melihhin0tr/Sensor_CARD_V2/SensorV2/BOM/BOM_BME_2801_2026-05-30.csv

ID | Name | Designator | Footprint | Quantity | Manufacturer Part | Manufacturer | Supplier | Supplier Part | Price | Pins | 3DModel | Contributor | JLCPCB Part Class | Package Display | link | subpart_no | tags
1 | 4000Hz | BUZZER | BUZ-SMD_L4.0-W4.0-P3.50-L | 1 | FUET-4020 | FUET(福声科技) | LCSC | C391027 | 0.806 | 2 | BUZ-SMD_2P-L4.0-W4.0-H2.0 | LCSC | Extended Part | Yes | https://item.szlcsc.com/367489.html
2 | 4.7kΩ | R18 | R0603 | 1 | RC0603FR-074K7L | YAGEO(国巨) | LCSC | C99782 | 0.002 | 2 | R0603 | lcsc | Extended Part | Yes | https://www.mouser.in/datasheet/2/447/PYu_RT_1_to_0_01_RoHS_L_11-1669912.pdf
3 | 1kΩ | R19 | R0603 | 1 | RC0603FR-071KL | YAGEO(国巨) | LCSC | C22548 | 0.002 | 2 | R0603 | lcsc | Extended Part | Yes | https://www.mouser.in/datasheet/2/447/PYu_RT_1_to_0_01_RoHS_L_11-1669912.pdf
4 | BC847_C2913847 | U4 | SOT-23-3_L2.9-W1.3-P1.90-LS2.3-BR-1 | 1 | BC847 | null | LCSC | C2913847 |  | 3 | SOT-23-3_L2.9-W1.3-P1.90-LS2.3-BR-1 | LCSC | Extended Part | No | https://atta.szlcsc.com/upload/public/pdf/source/20190910/C426794_71CDF14A270A64EC9B81A2413D2B22AD.pdf
5 | 10K | R20 | R0603 | 1 |  |  |  |  |  | 2 | R0603 | LCEDA_Lib |  | No | https://www.mouser.in/datasheet/2/447/PYu_RT_1_to_0_01_RoHS_L_11-1669912.pdf
6 | 10uF | C14 | C0603 | 1 | CL10A106KP8NNNC | SAMSUNG(三星) | LCSC | C19702 | 0.013 | 2 | C0603_L1.6-W0.8-H0.8 | lcsc | Basic Part | Yes | https://item.szlcsc.com/362304.html
7 | 353120460 | I2C1,UART4 | CONN-TH_353120460 | 2 | 353120460 | MOLEX | LCSC | C185200 | 0.287 | 4 | CONN-TH_353120460 | LCSC | Extended Part | Yes | https://item.szlcsc.com/196605.html
8 | 22Ω | R15,R16 | R0603 | 2 | RC0603FR-0722RL | YAGEO(国巨) | LCSC | C107701 | 0.002 | 2 | R0603 | lcsc | Extended Part | No | https://www.mouser.in/datasheet/2/447/PYu_RT_1_to_0_01_RoHS_L_11-1669912.pdf
9 | 10kΩ | RN1 | RES-ARRAY-SMD_0402-8P-L2.0-W1.0-BL | 1 | EXB28V103JX | PANASONIC(松下) | LCSC | C178757 | 0.019 | 8 | R0402-8P_L2.0-W1.0-H0.5 | LCSC | Extended Part | Yes | https://item.szlcsc.com/310999.html
10 | 0.1uF | C23,C26 | C0603 | 2 |  |  |  |  |  | 2 | C0603_L1.6-W0.8-H0.8 | LCEDA_Lib |  | No | https://item.szlcsc.com/362304.html
11 | 1 uF | C24 | C0603 | 1 |  |  |  |  |  | 2 | C0603_L1.6-W0.8-H0.8 | LCEDA_Lib |  | No | https://item.szlcsc.com/362304.html
12 | TF PUSH | CARD1 | TF-SMD_TF-PUSH | 1 | TF PUSH | SHOU HAN(首韩) | LCSC | C393941 | 0.066 | 13 | TF-SMD_TF-PUSH | LCSC | Extended Part | Yes | https://item.szlcsc.com/372553.html
13 | 10K | R17 | R0603 | 1 |  |  |  |  |  | 2 | R0603 | LCEDA_Lib |  | Yes | https://www.mouser.in/datasheet/2/447/PYu_RT_1_to_0_01_RoHS_L_11-1669912.pdf
14 | ASM330LHHTR | U6 | LGA-14L_L3.0-W2.5-P0.50-TL | 1 | ASM330LHHTR | ST(意法半导体) | LCSC | C459826 | 5.567 | 14 | LGA-14_L2.5-W3.0-H0.9-P0.50 | LCSC | Extended Part | Yes | https://cn.bing.com/search?q=datasheet： IIS3DWBTR
15 | 353120460 | CN1 | CONN-TH_353120460 | 1 | 353120460 | MOLEX | LCSC | C185200 | 0.287 | 4 | CONN-TH_353120460 | LCSC | Extended Part |  | https://item.szlcsc.com/196605.html
16 | 4.7kΩ | R5,R6,R7 | R0603 | 3 | RC0603FR-074K7L | YAGEO(国巨) | LCSC | C99782 | 0.002 | 2 | R0603 | lcsc | Extended Part | No | https://www.mouser.in/datasheet/2/447/PYu_RT_1_to_0_01_RoHS_L_11-1669912.pdf
17 | 47Ω | R10 | R0603 | 1 | RC0603FR-0747RL | YAGEO(国巨) | LCSC | C114623 | 0.002 | 2 | R0603 | lcsc | Extended Part | No | https://www.mouser.in/datasheet/2/447/PYu_RT_1_to_0_01_RoHS_L_11-1669912.pdf
18 | 5.1kΩ | R13,R14 | R0603 | 2 | 0603WAF5101T5E | UNI-ROYAL(厚声) | LCSC | C23186 | 0.002 | 2 | R0603 | lcsc | Basic Part | No | https://www.mouser.in/datasheet/2/447/PYu_RT_1_to_0_01_RoHS_L_11-1669912.pdf
19 | HX 3X4X2-2P-1.6N TACTILE SWITCH | RST | KEY-SMD_L4.0-W3.0-LS4.9-1 | 1 | HX 3x4x2-2P-1.6N TACTILE SWITCH | hanxia(韩下) | LCSC | C49234124 | 0.019 | 2 | KEY-SMD_L4.0-W3.0-LS4.9 | lcsc | Extended Part | No | https://cn.bing.com/search?q=datasheet%3A+%20KEY_3x4X2_SMT
20 | 2.2uF | C5,C6,C13 | C0603 | 3 | CL10B225KP8NNNC | SAMSUNG(三星) | LCSC | C100082 | 0.011 | 2 | C0603_L1.6-W0.8-H0.8 | lcsc | Extended Part | No | https://item.szlcsc.com/362304.html
21 | 210S-1*2P L=11.6MMGold-plated black | BOOT0 | HDR-TH_2P-P2.54-V-M-1 | 1 | B-2100S02P-A110 | Ckmtw(灿科盟) | LCSC | C124375 | 0.03 | 2 | HDR-M-2.54_1x2 | LCSC | Extended Part | No | https://item.szlcsc.com/366904.html
22 | Header-Male-2.54_1x3 | POINT | HDR-TH_3P-P2.54-V-M-1 | 1 | 2.54-1*3P针 | BOOMELE(博穆精密) | LCSC | C49257 | 0.024 | 3 | HDR-M-2.54_1x3 | lcsc | Extended Part | No | https://item.szlcsc.com/50265.html
23 | 33Ω | R2,R3 | R0603 | 2 | RC0603FR-0733RL | YAGEO(国巨) | LCSC | C108661 | 0.002 | 2 | R0603 | lcsc | Extended Part | No | https://www.mouser.in/datasheet/2/447/PYu_RT_1_to_0_01_RoHS_L_11-1669912.pdf
24 | 560Ω | R4,R8,R11,R12 | R0603 | 4 | RC0603FR-07560RL | YAGEO(国巨) | LCSC | C114629 | 0.002 | 2 | R0603 | lcsc | Extended Part | Yes | https://www.mouser.in/datasheet/2/447/PYu_RT_1_to_0_01_RoHS_L_11-1669912.pdf
25 | BME280 | U1 | LGA-8_BME280_BL | 1 | BME280 | Bosch(博世) | LCSC | C92489 | 6.371 | 8 | LGA-8_L2.5-W2.5-H0.9-P0.65 | LCSC | Extended Part |  | https://item.szlcsc.com/93682.html
26 | STM32F407VGT6 | U2 | LQFP-100_L14.0-W14.0-P0.50-LS16.0-BL | 1 | STM32F407VGT6 | ST(意法半导体) | LCSC | C12345 | 5.687 | 100 | LQFP-100_L14.0-W14.0-H1.4-LS16.0-P0.50 | lcsc | Extended Part |  | https://item.szlcsc.com/417273.html | 1 | STM32
27 | TPS73033DBVRG4 | U3 | SOT-23-5_L3.0-W1.6-P0.95-LS2.8-BR | 1 | TPS73033DBVRG4 | TI(德州仪器) | LCSC | C3749348 | 0.902 | 5 | SOT-23-5_L3.0-W1.6-P0.95-LS2.8-BR | lcsc | Extended Part |  | https://atta.szlcsc.com/upload/public/pdf/source/20210423/C2682596_80E51577C889FCE8639E82E3A6FE92E9.pdf
28 | TYPE-C-31-M-12 | USBC1 | USB-C_SMD-TYPE-C-31-M-12_1 | 1 | TYPE-C-31-M-12 | 韩国韩荣 | LCSC | C165948 | 0.188 | 16 | USB-C_SMD-TYPE-C-31-M-12_1 | LCSC | Extended Part |  | https://item.szlcsc.com/datasheet/TYPE-C-31-M-12/177331.html
29 | 8MHz | X1 | OSC-SMD_L5.0-W3.2 | 1 | TAXM8M2QLFCDT1T | YJX(雅晶鑫) | LCSC | C122522 | 0.218 | 2 | OSC-SMD_L5.0-W3.2-H1.4 | LCSC | Extended Part |  | https://lcsc.com/product-detail/SMD-Crystal-Resonators_Yangxing-Tech-X50328MSF2GI_C58297.html
30 | USBLC6-2SC6 | D1 | SOT-23-6_L2.9-W1.6-P0.95-LS2.8-BL | 1 | USBLC6-2SC6 | ST(意法半导体) | LCSC | C7519 | 0.152 | 6 | SOT-23-6_L2.9-W1.6-H1.5-LS2.8-P0.95 | lcsc | Extended Part | No | https://item.szlcsc.com/169042.html
31 | B5819WSL-TP | D2 | SOD-323F_L2.0-W1.6-LS2.5-RD | 1 | B5819WSL-TP | MCC(美微科) | LCSC | C19984182 | 0.043 | 2 | SOD-323F_L1.6-W1.3-H1.1-LS2.7 | lcsc | Extended Part | No | https://item.szlcsc.com/111628.html
32 | YLED0805RA | LED2,LED1,STM,USB | LED0805-FD | 4 | YLED0805RA | YONGYUTAI(永裕泰) | LCSC | C52989003 | 0.016 | 2 | LED0805_Inf | lcsc | Extended Part | No | https://item.szlcsc.com/378103.html
33 | 1uF | C1,C3 | C0402 | 2 | CL05A105KP5NNNC | SAMSUNG(三星) | LCSC | C14445 | 0.003 | 2 | C0402_L1.0-W0.5-H0.5 | lcsc | Extended Part | No | https://item.szlcsc.com/15869.html
34 | 100nF | C2,C4,C7,C11 | C0603 | 4 | CC0603KRX7R9BB104 | YAGEO(国巨) | LCSC | C14663 | 0.004 | 2 | C0603_L1.6-W0.8-H0.8 | lcsc | Basic Part | No | https://item.szlcsc.com/362304.html
35 | 33pF | C8,C9 | C0603 | 2 | CL10C330JB8NNNC | SAMSUNG(三星) | LCSC | C1663 | 0.006 | 2 | C0603_L1.6-W0.8-H0.8 | lcsc | Basic Part | No | https://item.szlcsc.com/362304.html
36 | 10uF | C12 | C0603 | 1 | CL10A106KP8NNNC | SAMSUNG(三星) | LCSC | C19702 | 0.013 | 2 | C0603_L1.6-W0.8-H0.8 | lcsc | Basic Part | No | https://item.szlcsc.com/362304.html
37 | 10kΩ | R1,R9 | R0603 | 2 | RC0603FR-0710KL | YAGEO(国巨) | LCSC | C98220 | 0.002 | 2 | R0603 | lcsc | Extended Part | No | https://www.mouser.in/datasheet/2/447/PYu_RT_1_to_0_01_RoHS_L_11-1669912.pdf
38 | 47uF | C10 | C0603 | 1 | GRM188R60J476ME15D | muRata(村田) | LCSC | C140782 | 0.104 | 2 | C0603_L1.6-W0.8-H0.8 | LCSC | Extended Part | No | https://item.szlcsc.com/362304.html
