melihhin0tr/Sensor_CARD_V2/SensorV2/Şematik Dosyalar/PDF/Schematic_BME_2801_2026-05-30.pdf

VSS 10 VDD 11 PH0 12 PH1 13 NRST 14 PC0 15 PC1 16 PC2 17 PC3 18 VDD 19 VSSA 20 VREF+ 21 VDDA 22 PA0 23 PA1 24 PA2 25 PA3 26 VSS 27 VDD 28 PA4 29 PA5 30 PA6 31 PA7 32 PC4 33 PC5 34 PB0 35 PB1 36 PB2 37 PE738 PE839 PE940 PE10 41 PE11 42 PE12 43 PE13 44 PE14 45 PE15 46 PB10 47 PB11 48 VCAP_1 49 VDD 50 PB12 51

GND A1B12 VBUS A4B9 SBU2 B8 CC1 A5 DN2 B7 DP1 A6 DN1 A7 DP2 B6 SBU1 A8 CC2 B5 VBUS B4A9 GND B1A12

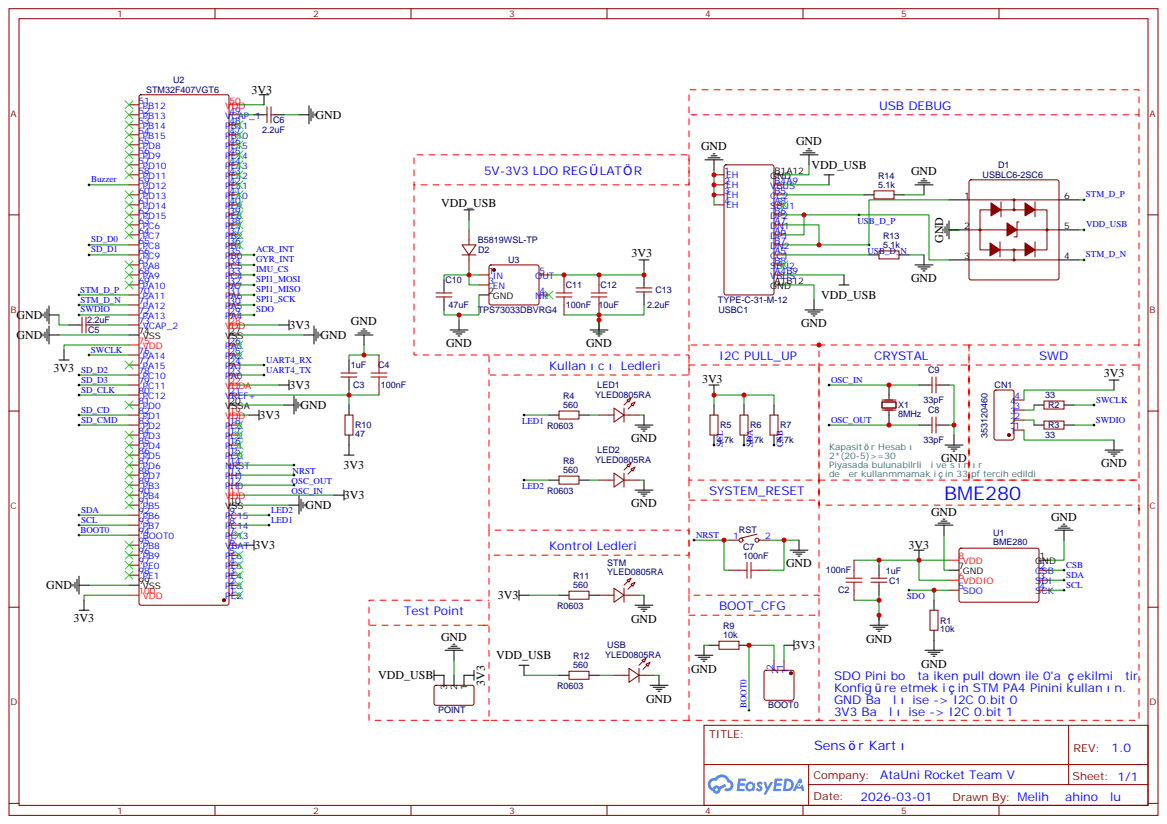
[picture p1: page 1]

Kapasit r Hesab
de er kullanmmamak i in 33 pf tercih edildi

SDO Pini bo ta iken pull down ile 0'a ekilmi tir.
Konfig re etmek i in STM PA4 Pinini kullan n.
GND Ba l ise -> I2C 0.bit 0
3V3 Ba l ise -> I2C 0.bit 1

Company: AtaUni Rocket Team V

Drawn By: Melih ahino lu

## SD CARD

## Buzzer

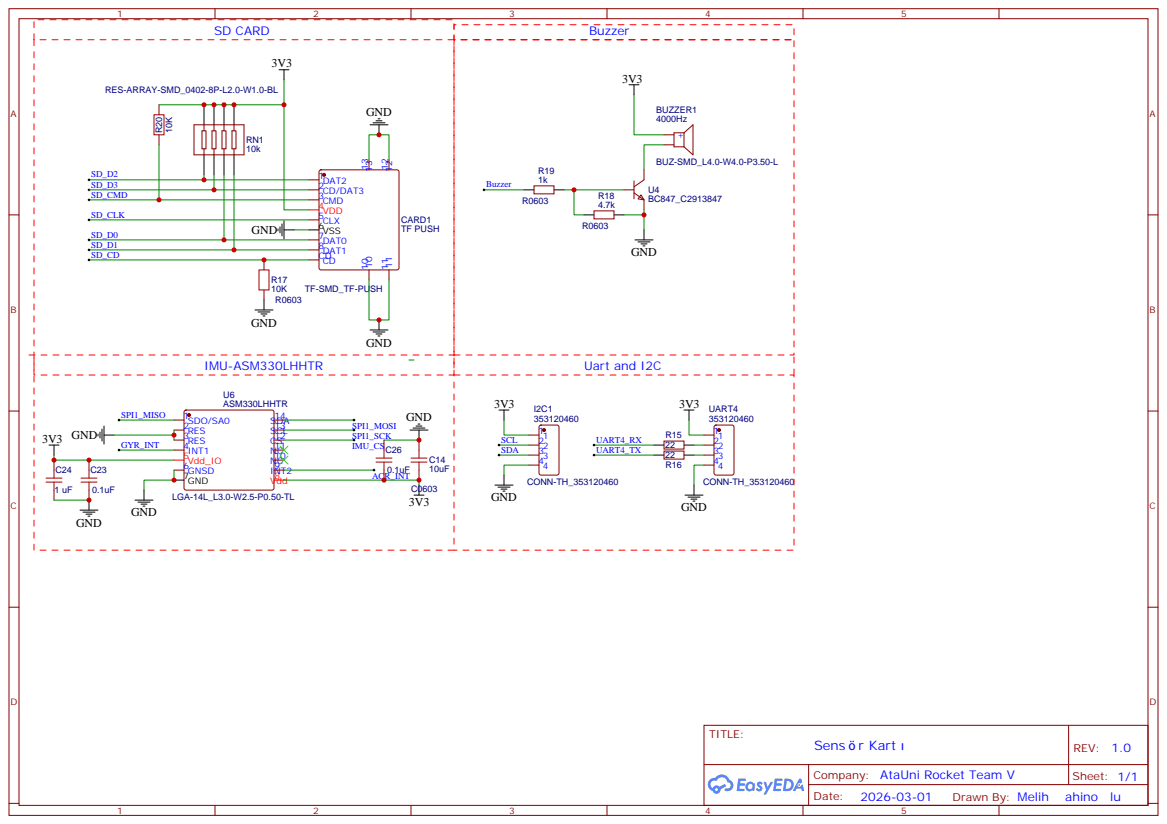
[picture p2: page 2]

Company: AtaUni Rocket Team V

Drawn By: Melih ahino lu
