melihhin0tr/Sensor_CARD_V2/(list of files, drawings)

Other design files:
SensorV2/Şematik Dosyalar/JSON/PCB_Sensor_V2.json
